spassigl/KicadLibs/3D Models/D6R90F1LFS.stp

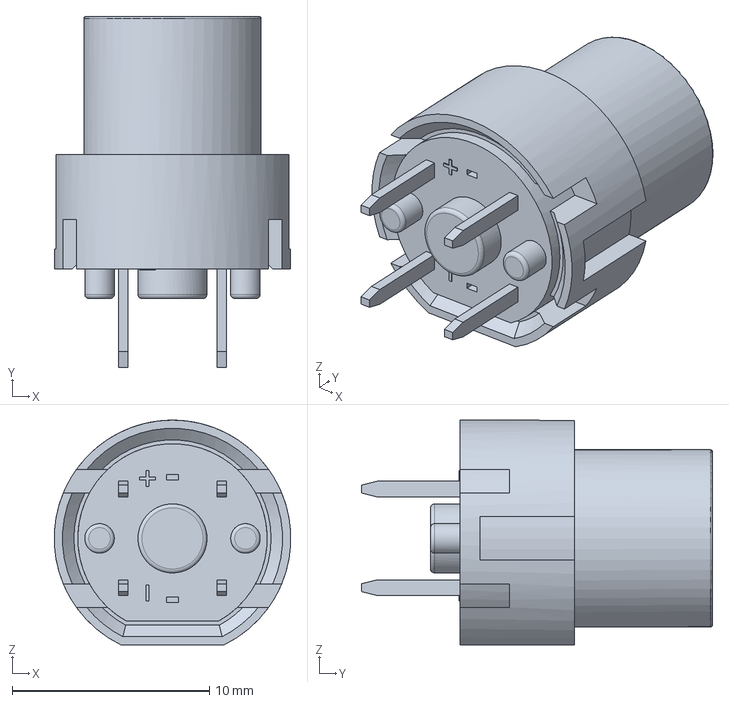
[picture p1: CAD file, 2026-04-27]
3D Models/D6R90F1LFS.stp
12.0 x 17.8 x 11.4 mm
