spassigl/KicadLibs/3D Models/GT-TC149B-H150-L1.step

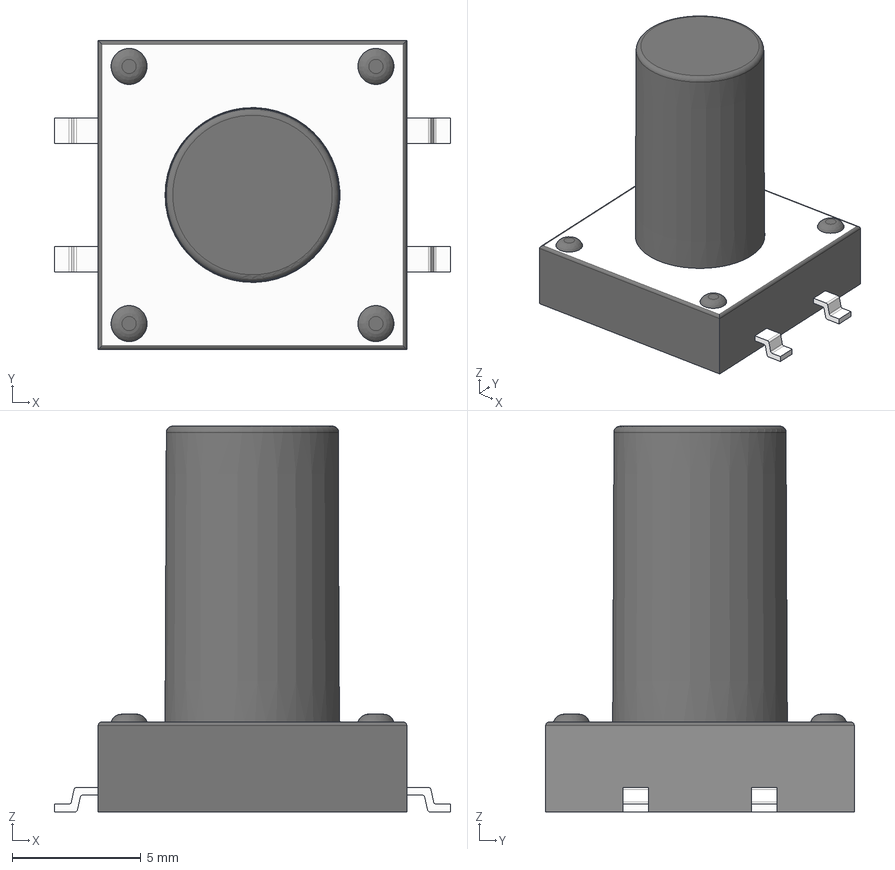
[picture p2: CAD file, 2026-04-27]
3D Models/GT-TC149B-H150-L1.step
15.4 x 12.0 x 15.0 mm
Base
Plunger
J-Lead
