spassigl/KicadLibs/3D Models/Cap.step

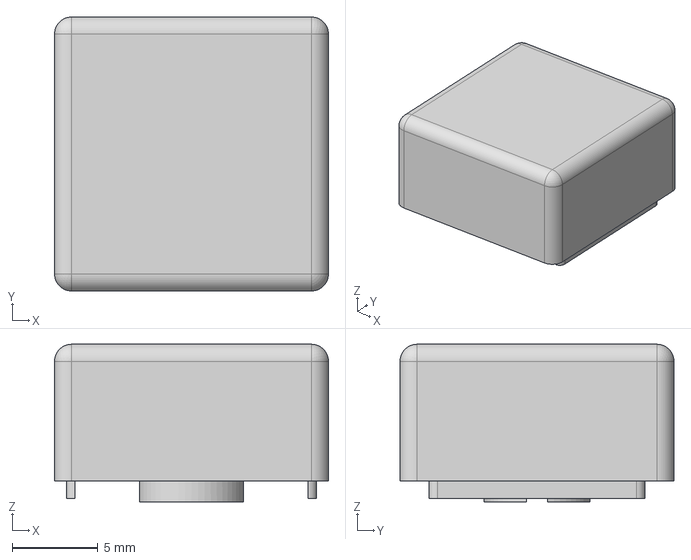
[picture p3: CAD file, 2026-04-27]
3D Models/Cap.step
16.0 x 16.0 x 9.20 mm
