spassigl/KicadLibs/3D Models/KS DELPS1.22.step

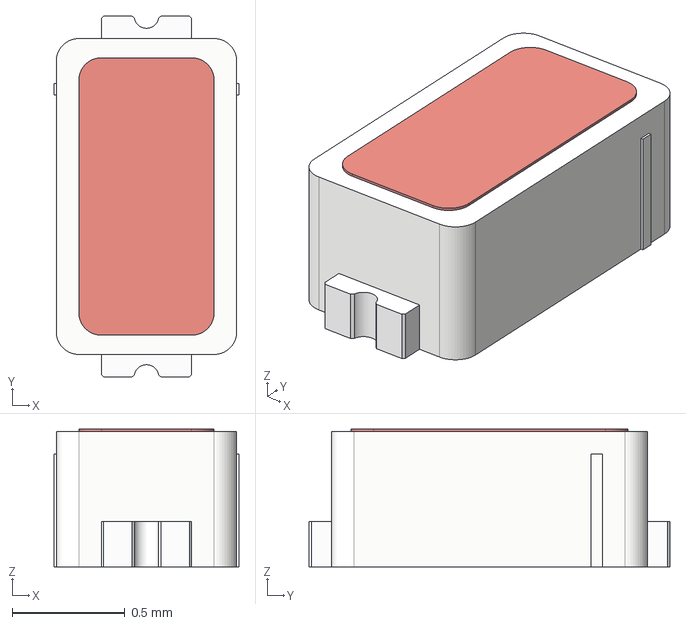
[picture p4: CAD file, 2026-04-27]
3D Models/KS DELPS1.22.step
0.82 x 1.60 x 0.61 mm
