spassigl/KicadLibs/3D Models/6Jxxx.stp

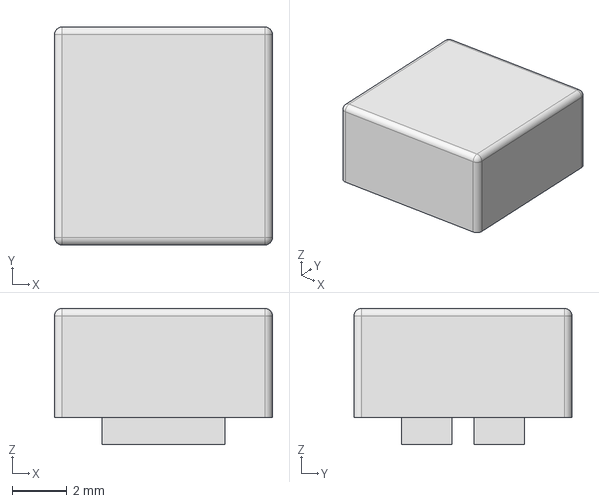
[picture p5: CAD file, 2026-04-27]
3D Models/6Jxxx.stp
8.00 x 8.00 x 5.00 mm
