spassigl/KicadLibs/3D Models/320.02E11xxx + 320.094.step

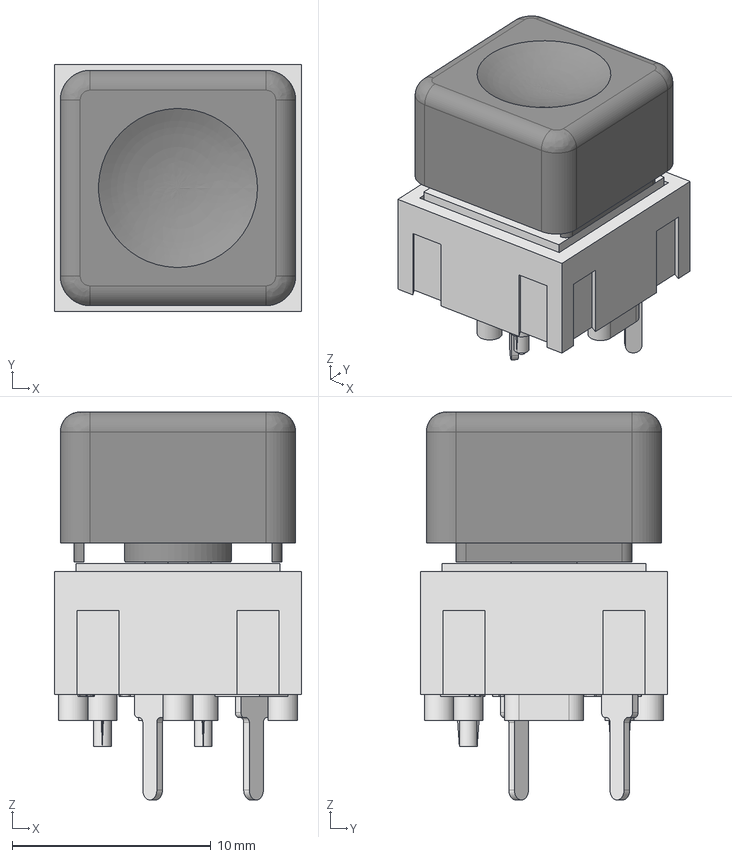
[picture p6: CAD file, 2026-04-27]
3D Models/320.02E11xxx + 320.094.step
12.5 x 12.4 x 19.5 mm
