spassigl/KicadLibs/3D Models/Heling_MJ56882-B111-HR1-C.step

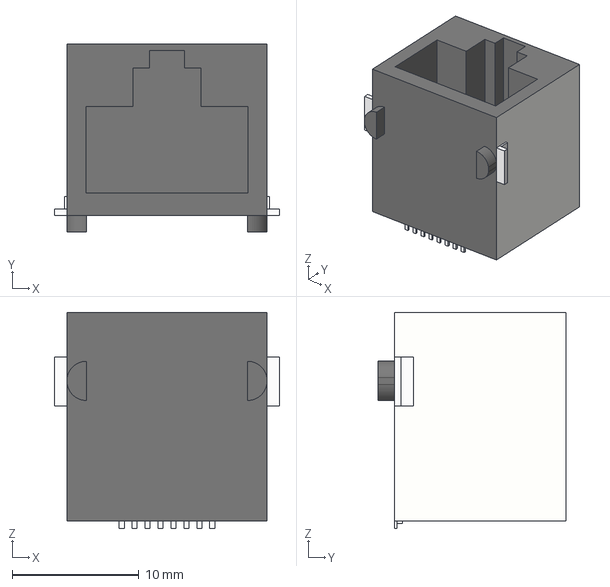
[picture p7: CAD file, 2026-04-27]
3D Models/Heling_MJ56882-B111-HR1-C.step
17.8 x 14.8 x 17.1 mm
