spassigl/KicadLibs/3D Models/320.02E11xxx.stp

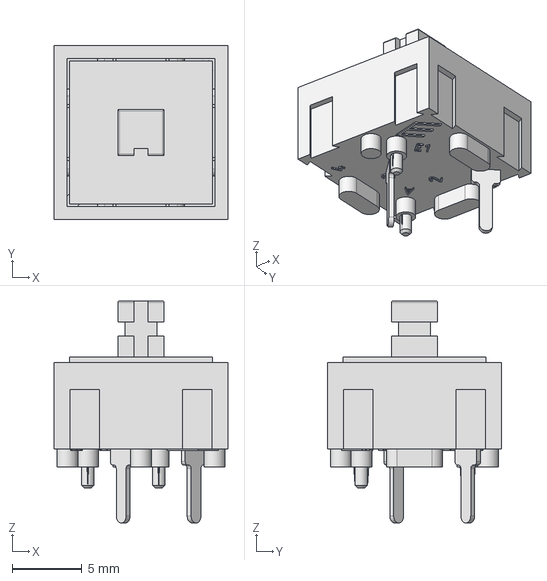
[picture p8: CAD file, 2026-04-27]
3D Models/320.02E11xxx.stp
12.5 x 12.4 x 15.9 mm
