spassigl/KicadLibs/3D Models/HRO TYPE-C-31-M-12.step

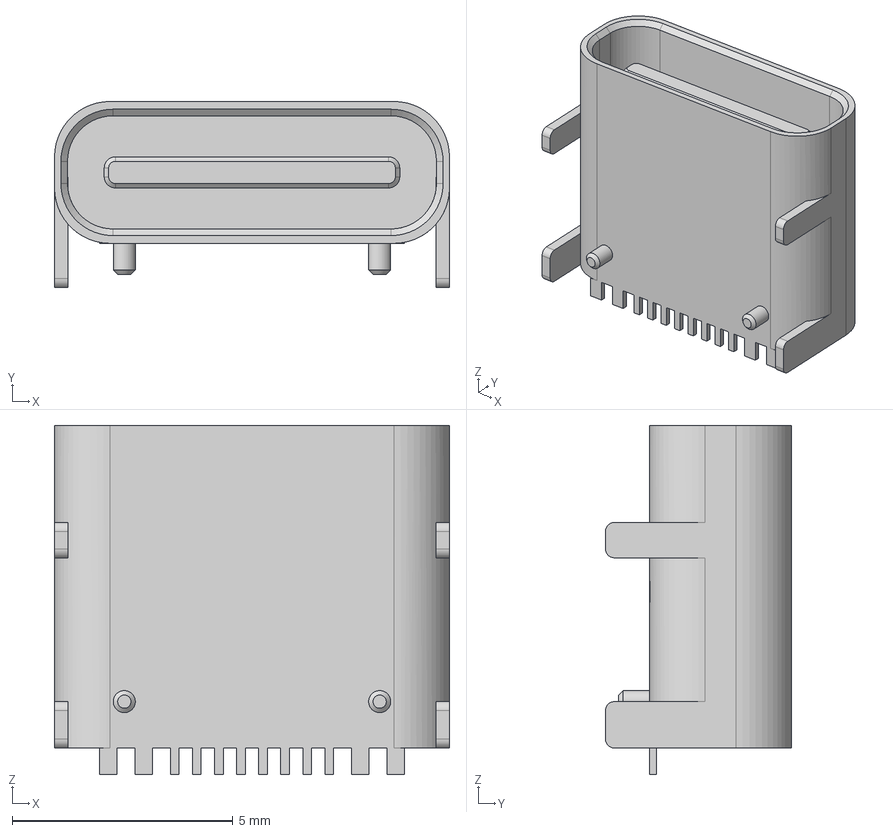
[picture p9: CAD file, 2026-04-27]
3D Models/HRO TYPE-C-31-M-12.step
8.94 x 4.21 x 7.90 mm
