spassigl/KicadLibs/3D Models/TL1100FFxxxx.stp

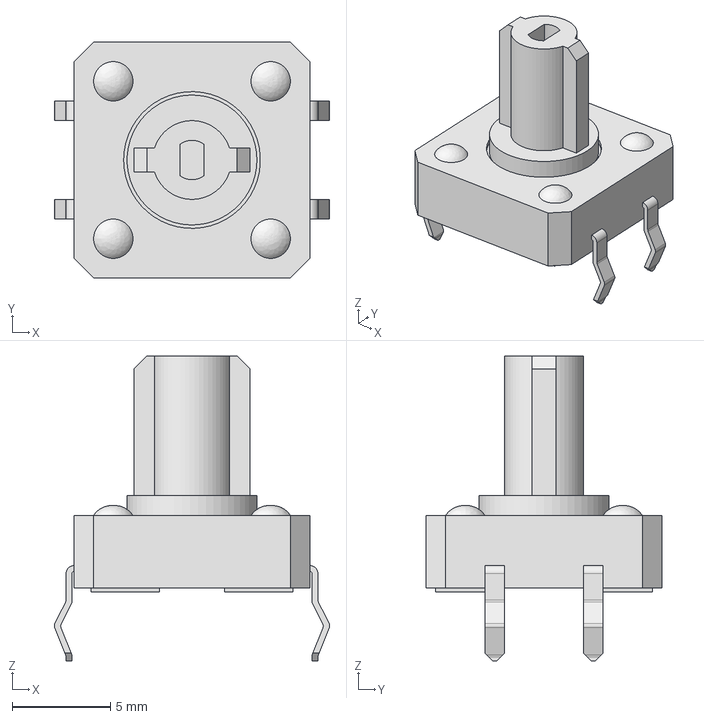
[picture p10: CAD file, 2026-04-27]
3D Models/TL1100FFxxxx.stp
14.0 x 12.0 x 15.5 mm
