spassigl/KicadLibs/3D Models/Omron G5Q-14.step

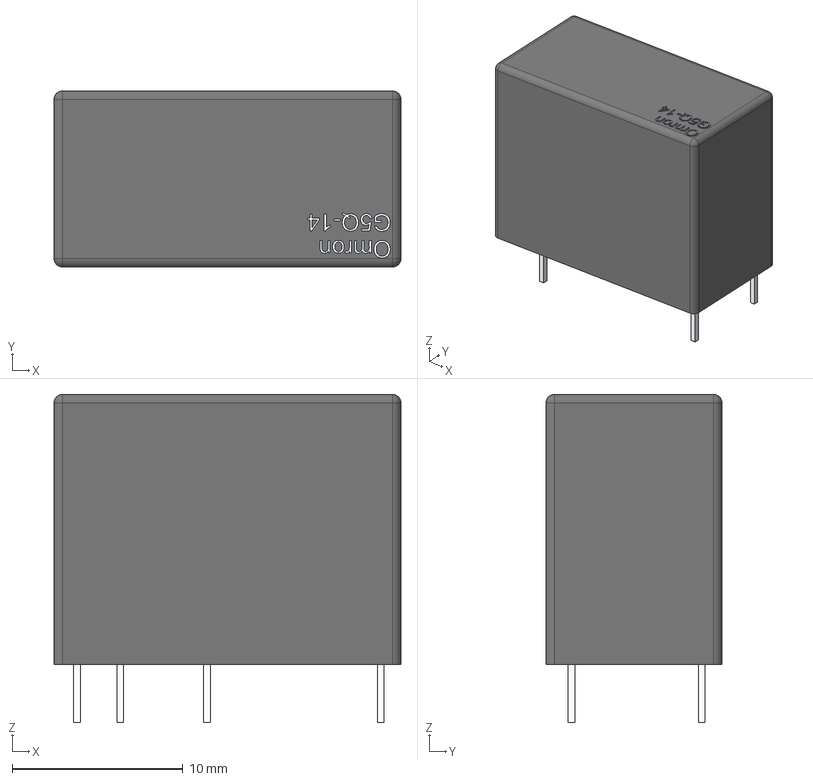
[picture p11: CAD file, 2026-04-27]
3D Models/Omron G5Q-14.step
20.3 x 10.3 x 19.2 mm
