spassigl/KicadLibs/3D Models/TS-1045-A13B3-D2.step

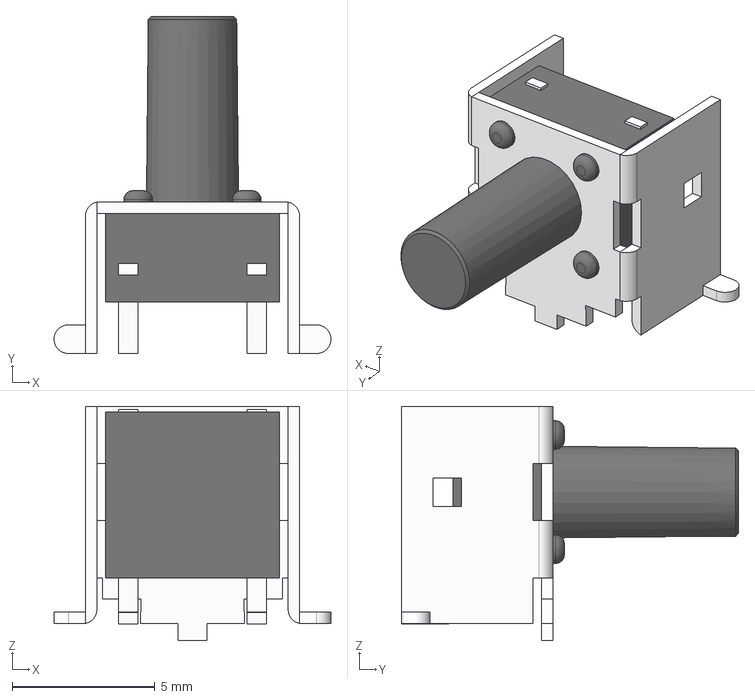
[picture p12: CAD file, 2026-04-27]
3D Models/TS-1045-A13B3-D2.step
9.70 x 11.8 x 8.20 mm
Cage
Switch body
