spassigl/KicadLibs/3D Models/PC817SMD-4.step

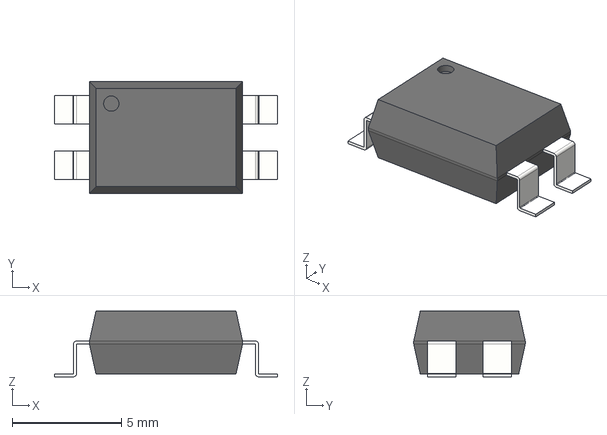
[picture p13: CAD file, 2026-04-27]
3D Models/PC817SMD-4.step
10.2 x 5.10 x 3.00 mm
