spassigl/KicadLibs/3D Models/B3F-105x.step

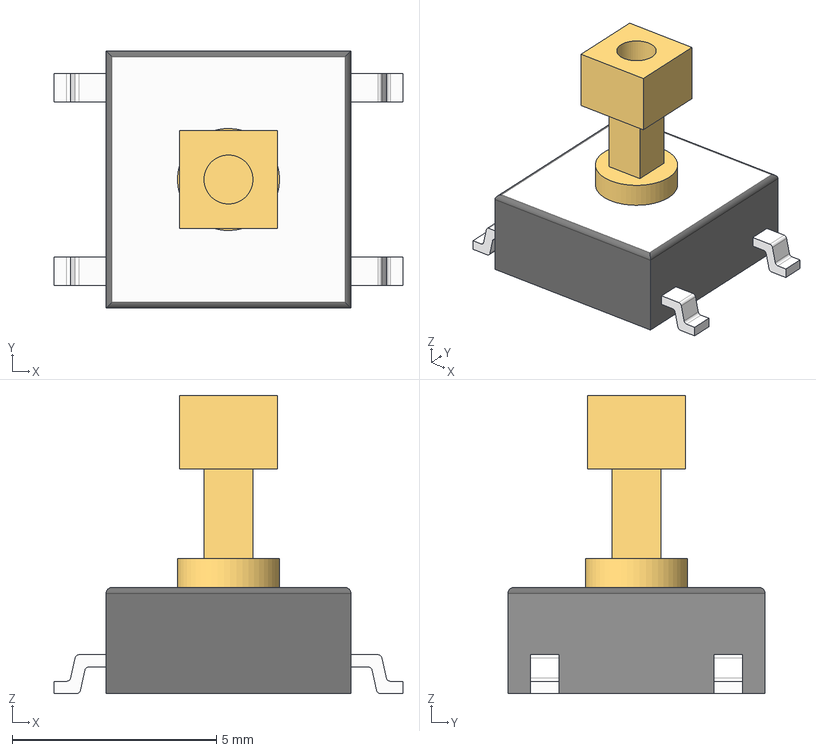
[picture p14: CAD file, 2026-04-27]
3D Models/B3F-105x.step
8.55 x 6.30 x 7.30 mm
Base
J-Lead
Plunger
