spassigl/KicadLibs/3D Models/MLT-9650.step

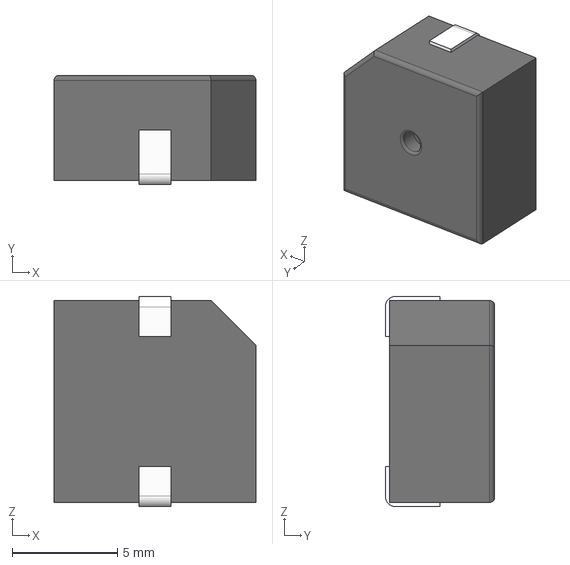
[picture p15: CAD file, 2026-04-27]
3D Models/MLT-9650.step
9.60 x 5.20 x 10.0 mm
