spassigl/KicadLibs/3D Models/PEC12R-4x22F-nxxxx.stp

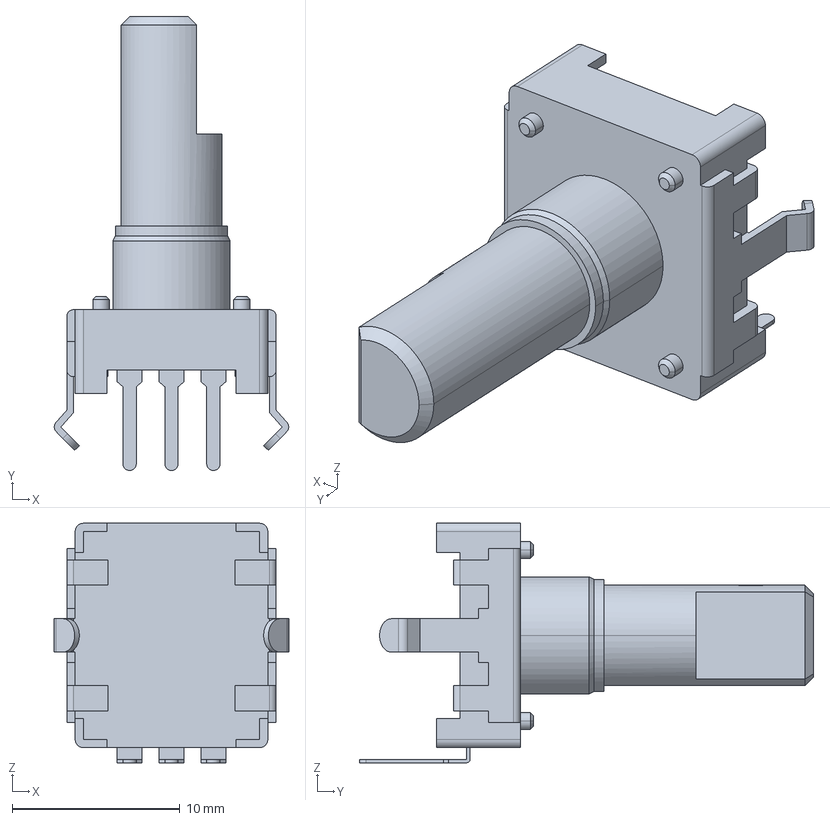
[picture p16: CAD file, 2026-04-27]
3D Models/PEC12R-4x22F-nxxxx.stp
14.0 x 27.1 x 14.3 mm
