spassigl/KicadLibs/3D Models/WQFN20_RUK_TEX.step

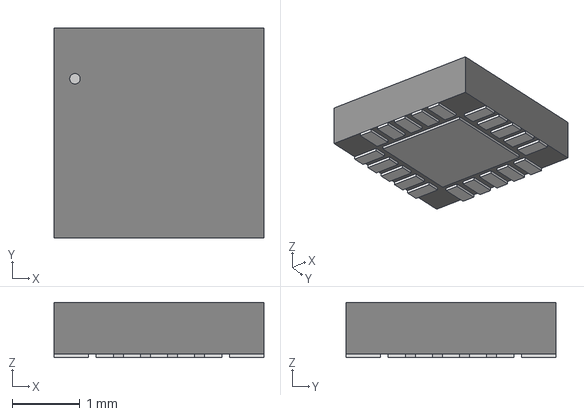
[picture p17: CAD file, 2026-04-27]
3D Models/WQFN20_RUK_TEX.step
3.10 x 3.10 x 0.815 mm
