spassigl/KicadLibs/3D Models/PTS126Jx73-SMT.step

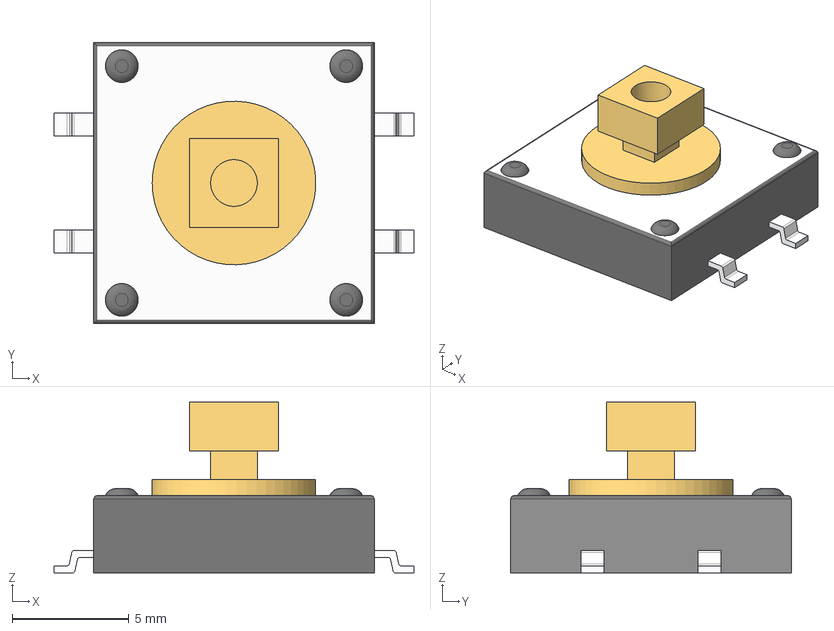
[picture p18: CAD file, 2026-04-27]
3D Models/PTS126Jx73-SMT.step
15.4 x 12.0 x 7.31 mm
Base
J-Lead
Plunger
