spassigl/KicadLibs/3D Models/KRTB LFLP71.32.step

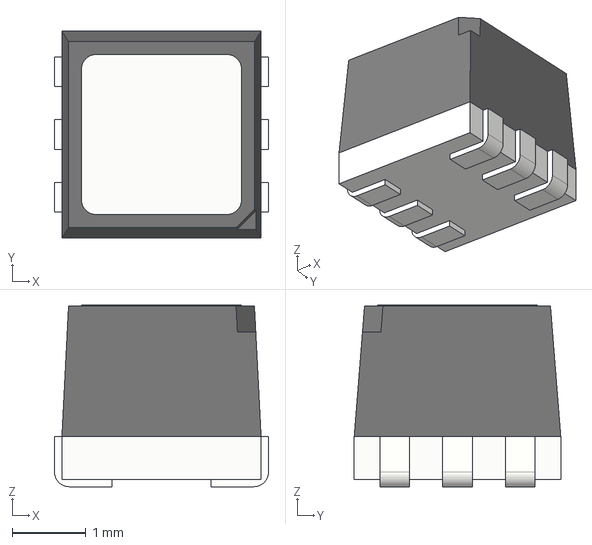
[picture p19: CAD file, 2026-04-27]
3D Models/KRTB LFLP71.32.step
2.90 x 2.80 x 2.46 mm
