spassigl/KicadLibs/3D Models/Encoder Knob D Shaft.step

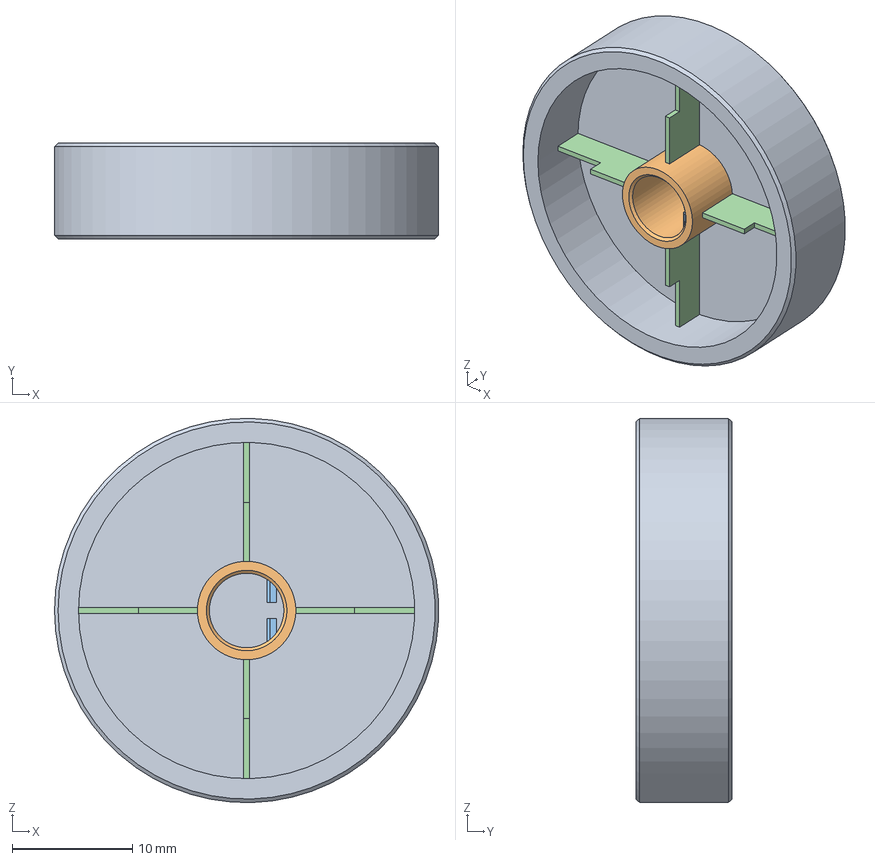
[picture p20: CAD file, 2026-04-27]
3D Models/Encoder Knob D Shaft.step
32.0 x 8.00 x 32.0 mm
