spassigl/KicadLibs/3D Models/ConnFly_DS1128_NoLED.step

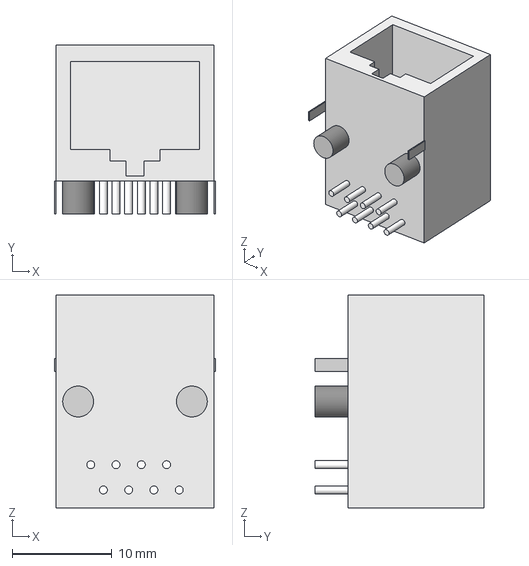
[picture p21: CAD file, 2026-04-27]
3D Models/ConnFly_DS1128_NoLED.step
16.2 x 16.9 x 21.4 mm
