spassigl/KicadLibs/3D Models/320.094xxx.stp

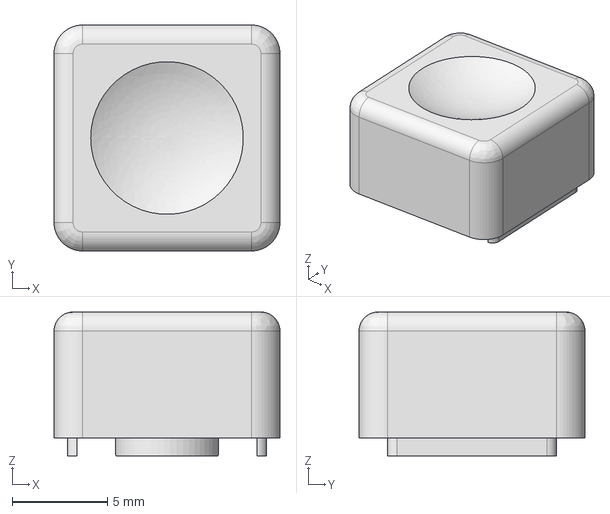
[picture p22: CAD file, 2026-04-27]
3D Models/320.094xxx.stp
11.8 x 11.8 x 7.55 mm
