spassigl/KicadLibs/3D Models/HF32FA.stp

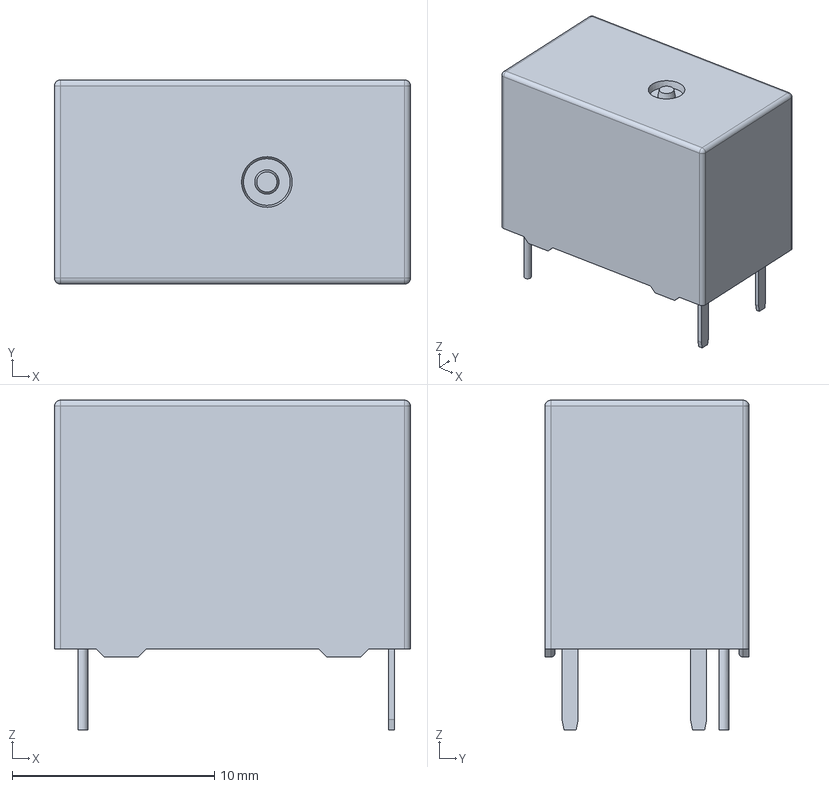
[picture p23: CAD file, 2026-02-20]
3D Models/HF32FA.stp
17.6 x 10.1 x 16.3 mm
