spassigl/KicadLibs/3D Models/WJ128V-5.0-02P-14-00A.step

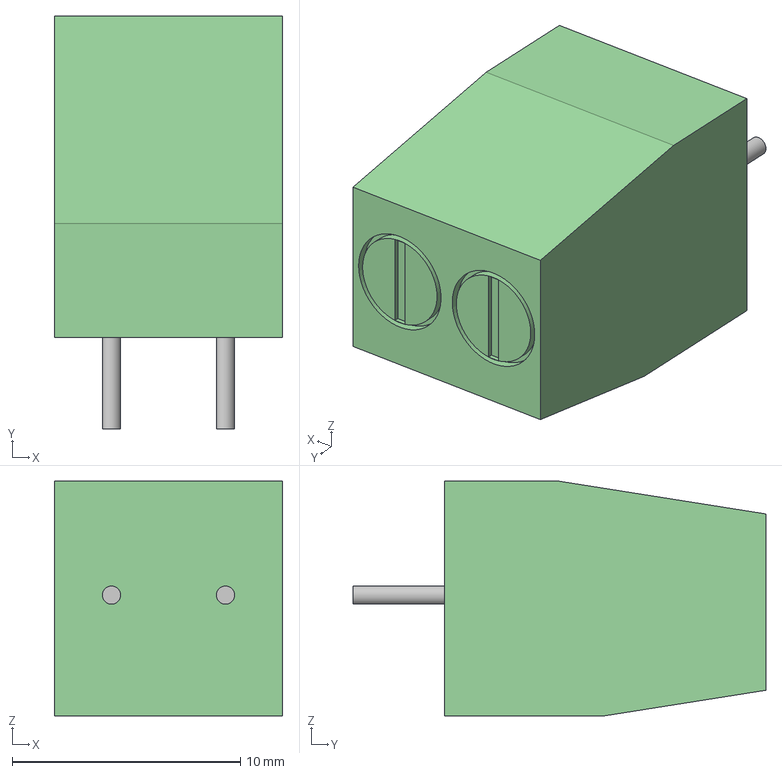
[picture p24: CAD file, 2026-02-20]
3D Models/WJ128V-5.0-02P-14-00A.step
10.0 x 18.1 x 10.3 mm
