spassigl/KicadLibs/3D Models/WJ129V-7.62-02P.step

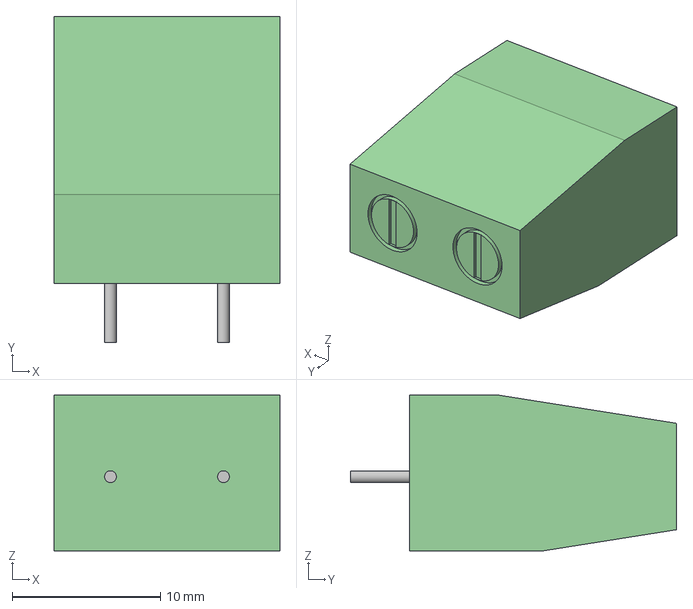
[picture p25: CAD file, 2026-02-20]
3D Models/WJ129V-7.62-02P.step
15.2 x 22.0 x 10.5 mm
