spassigl/KicadLibs/3D Models/FJ81XXXH.step

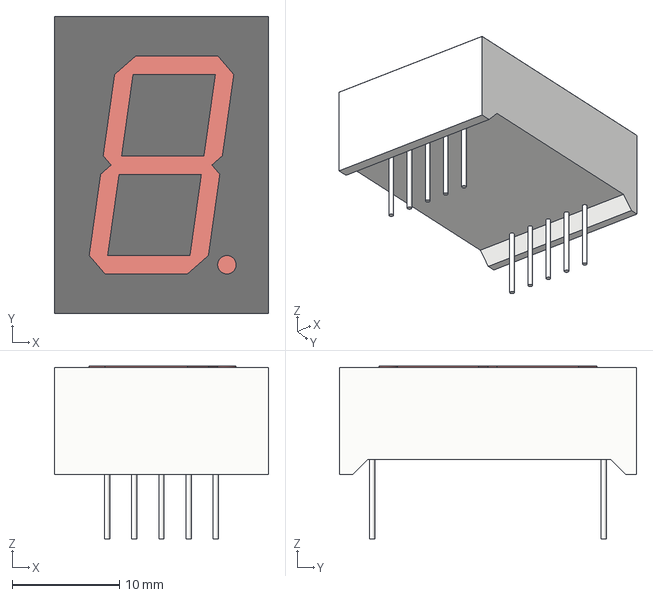
[picture p26: CAD file, 2026-02-15]
3D Models/FJ81XXXH.step
20.0 x 27.7 x 16.1 mm
