spassigl/KicadLibs/3D Models/SFN-12055PA6.5.step

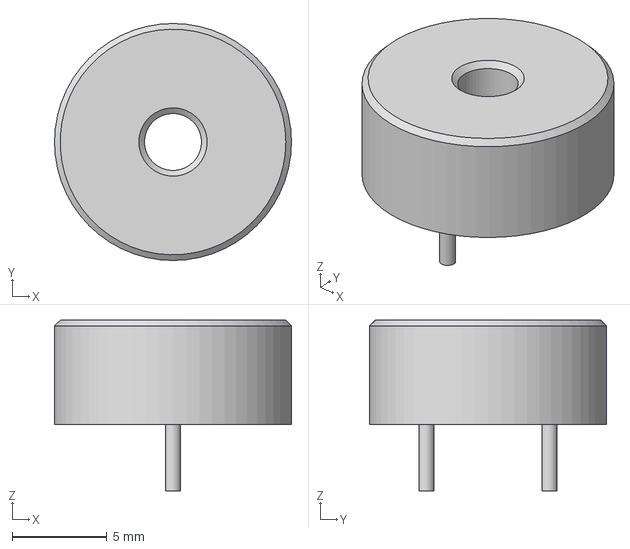
[picture p27: CAD file, 2026-02-15]
3D Models/SFN-12055PA6.5.step
12.5 x 12.5 x 9.00 mm
