spassigl/KicadLibs/3D Models/ESD5B5.step

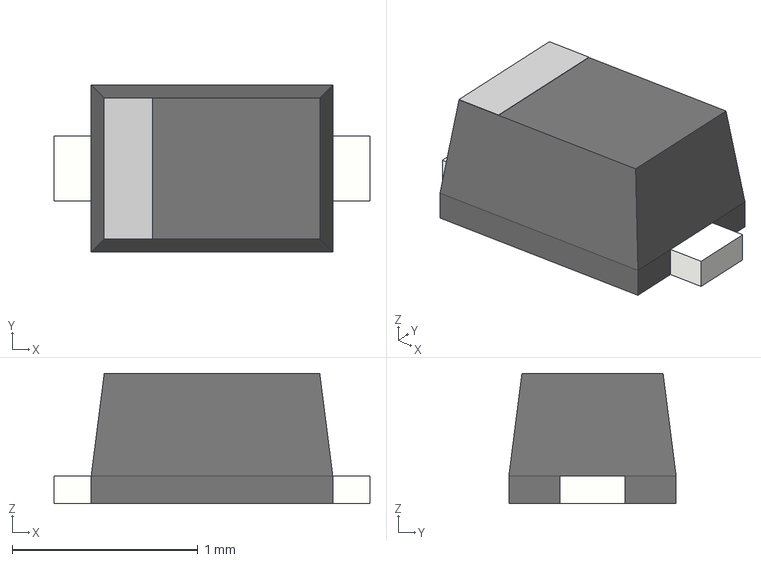
[picture p28: CAD file, 2026-02-15]
3D Models/ESD5B5.step
1.70 x 0.9 x 0.702 mm
