spassigl/KicadLibs/3D Models/NUP4114.step

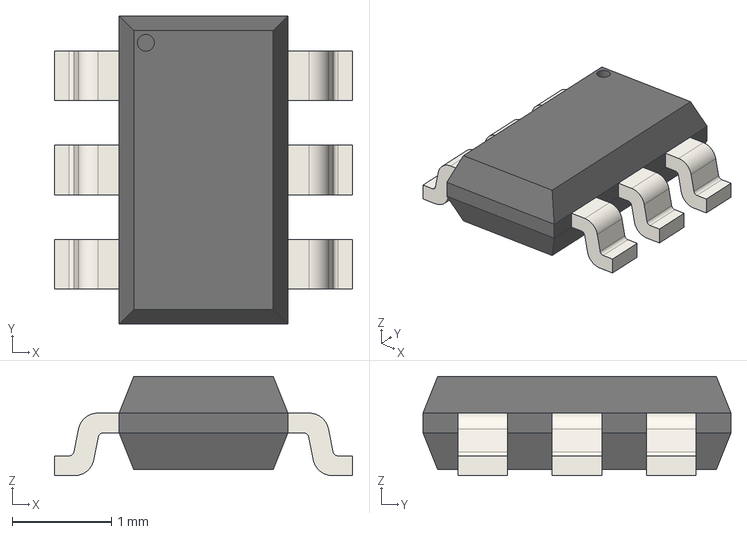
[picture p29: CAD file, 2026-02-15]
3D Models/NUP4114.step
3.00 x 3.10 x 1.00 mm
