spassigl/KicadLibs/3D Models/TM1637-DIP20.step

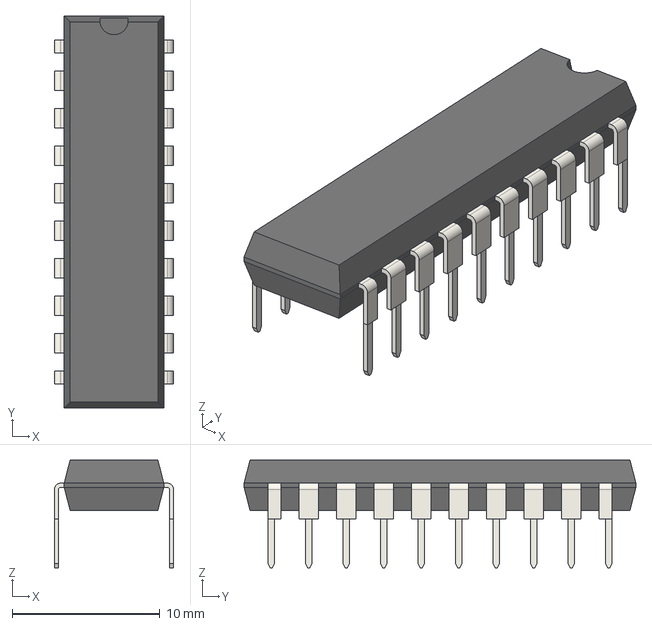
[picture p30: CAD file, 2026-02-15]
3D Models/TM1637-DIP20.step
8.06 x 26.5 x 7.30 mm
