spassigl/KicadLibs/3D Models/Schurter 0751.0110-2.step

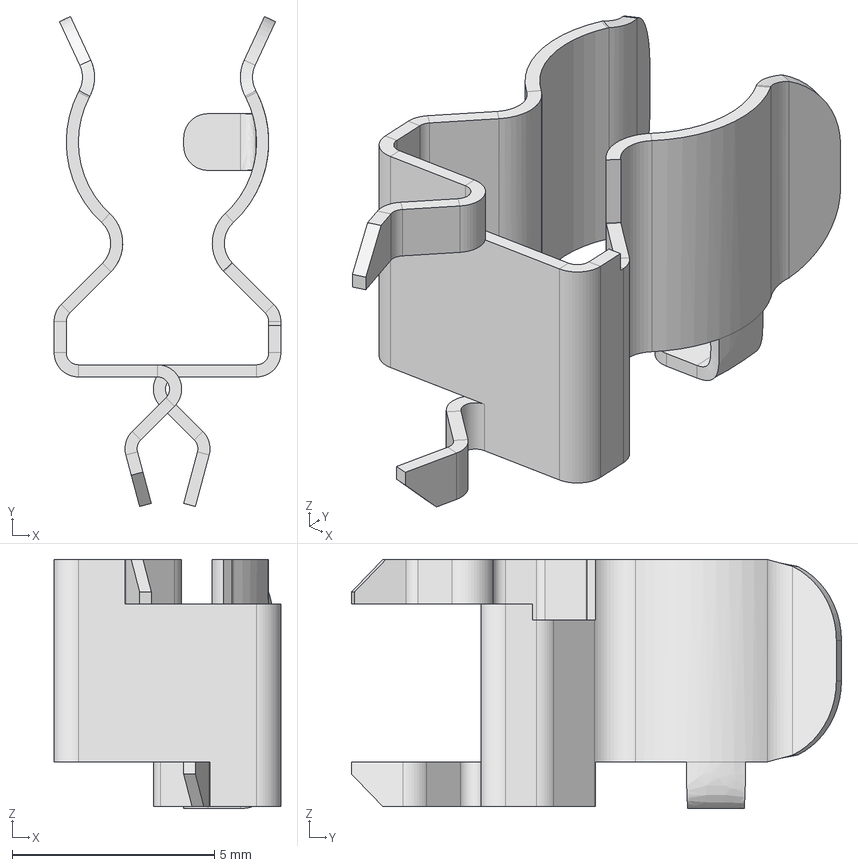
[picture p31: CAD file, 2026-02-15]
3D Models/Schurter 0751.0110-2.step
5.60 x 12.1 x 6.15 mm
