spassigl/KicadLibs/3D Models/IRM-10-5.step

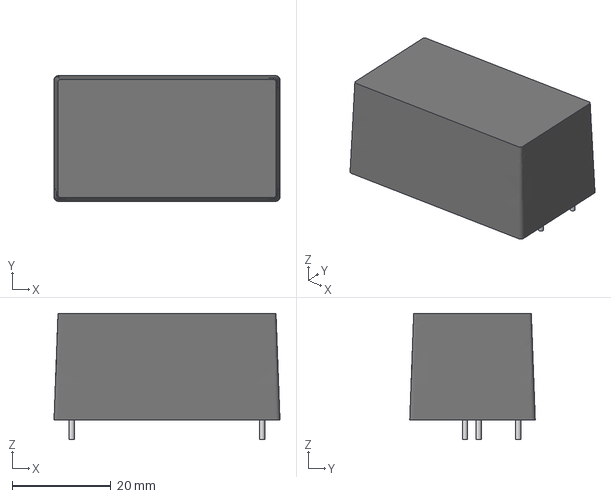
[picture p32: CAD file, 2026-02-15]
3D Models/IRM-10-5.step
45.7 x 25.4 x 25.5 mm
