spassigl/KicadLibs/3D Models/D6CXXF1LFS.step

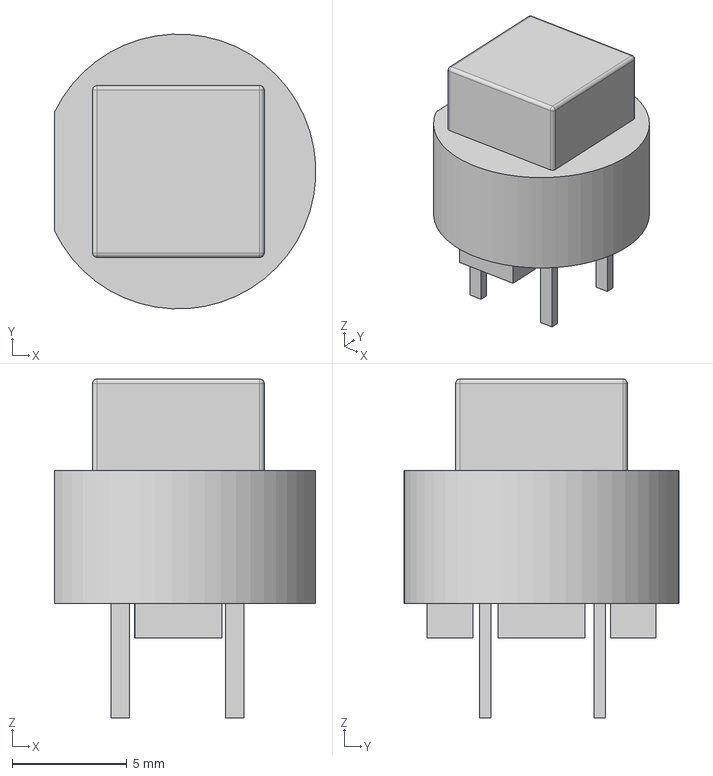
[picture p33: CAD file, 2026-02-15]
3D Models/D6CXXF1LFS.step
11.4 x 12.0 x 14.8 mm
