spassigl/KicadLibs/3D Models/07D511.step

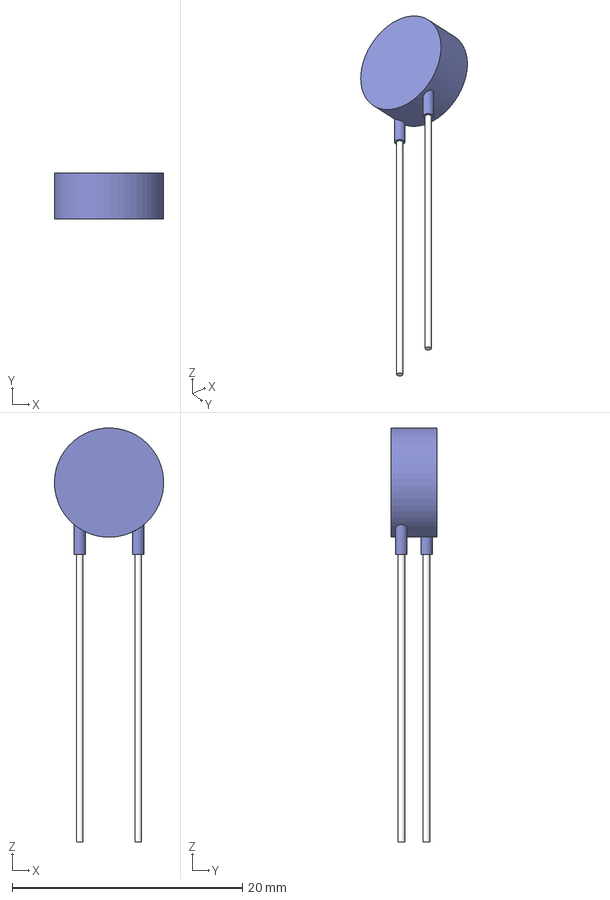
[picture p34: CAD file, 2026-02-15]
3D Models/07D511.step
9.49 x 4.00 x 36.0 mm
