spassigl/KicadLibs/3D Models/SPEF220100.step

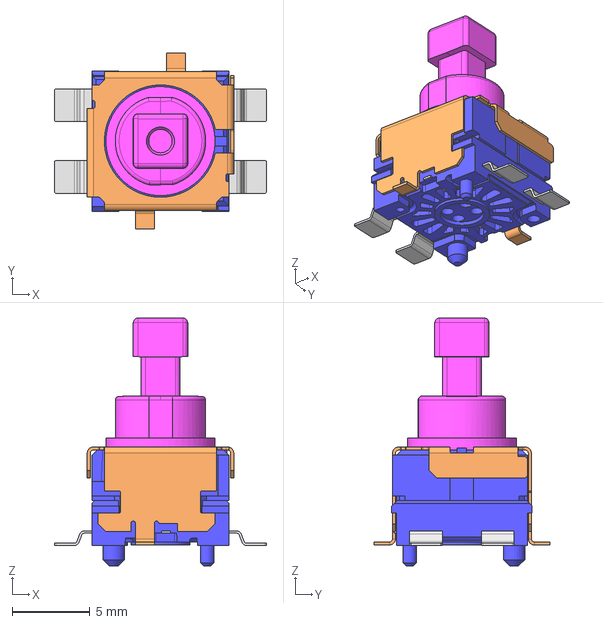
[picture p35: CAD file, 2026-02-15]
3D Models/SPEF220100.step
13.6 x 11.3 x 15.9 mm
