spassigl/KicadLibs/3D Models/TPD2E1B06.step

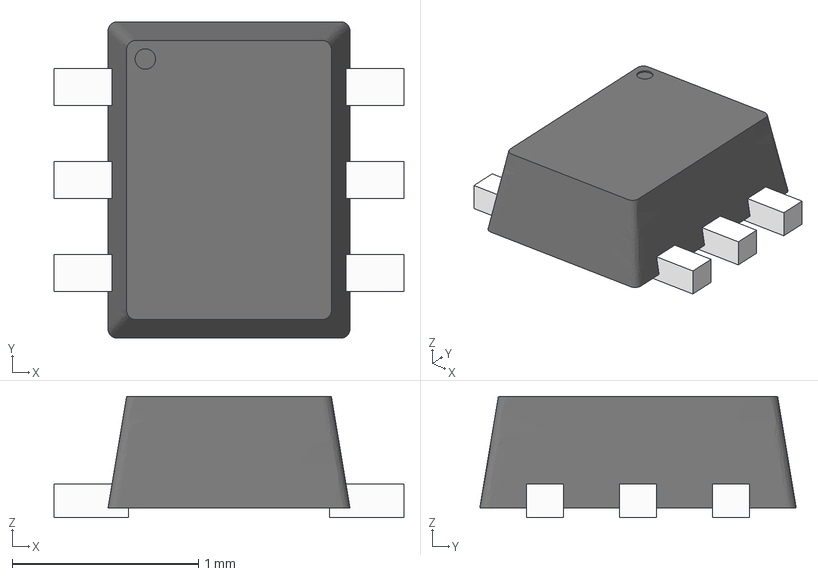
[picture p36: CAD file, 2026-02-15]
3D Models/TPD2E1B06.step
1.88 x 1.70 x 0.65 mm
