spassigl/KicadLibs/3D Models/G5CA-1A4.step

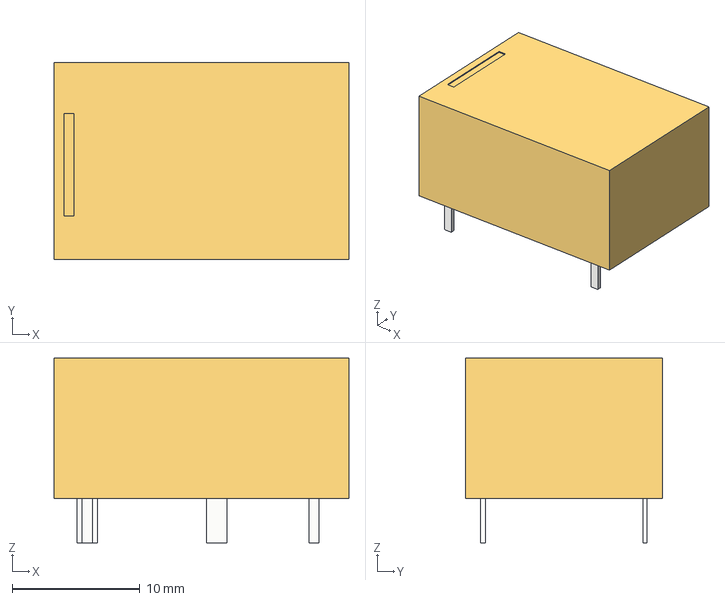
[picture p37: CAD file, 2026-02-15]
3D Models/G5CA-1A4.step
23.1 x 15.5 x 14.5 mm
