spassigl/KicadLibs/3D Models/NUD3124.step

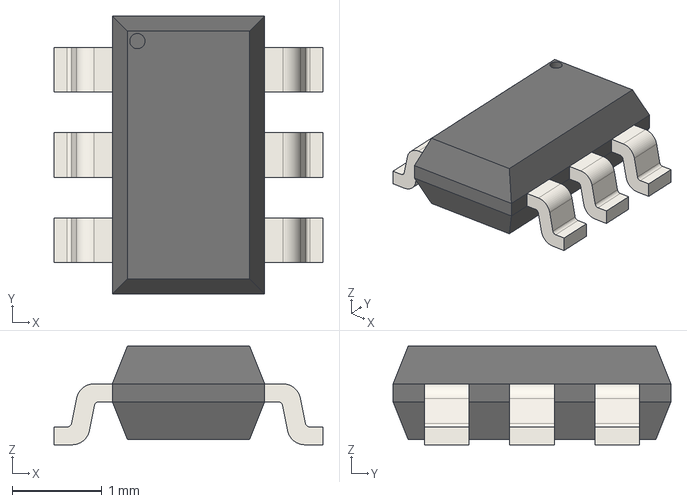
[picture p38: CAD file, 2026-02-15]
3D Models/NUD3124.step
3.00 x 3.10 x 1.10 mm
