spassigl/KicadLibs/3D Models/MAX7219-SOIC.step

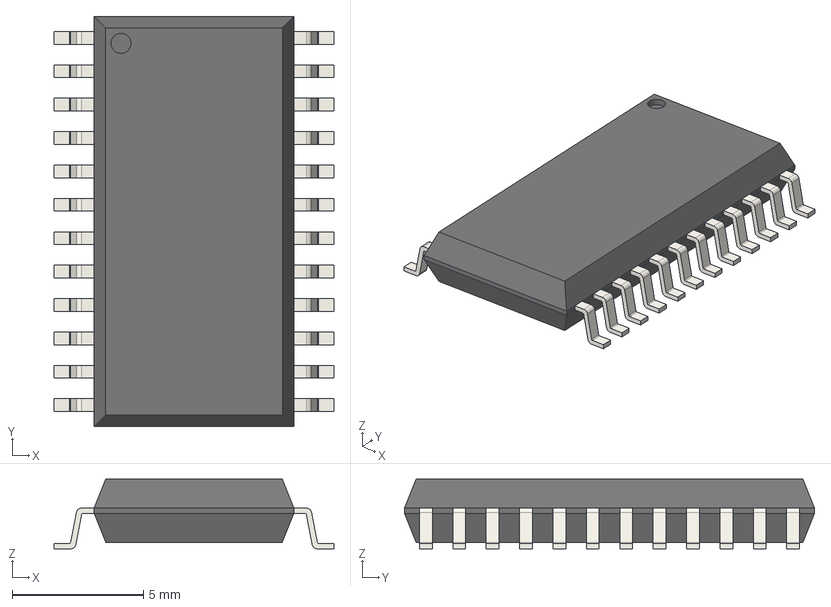
[picture p39: CAD file, 2026-02-15]
3D Models/MAX7219-SOIC.step
10.7 x 15.6 x 2.65 mm
