spassigl/KicadLibs/3D Models/TS-1095PD-A17B3-D2.step

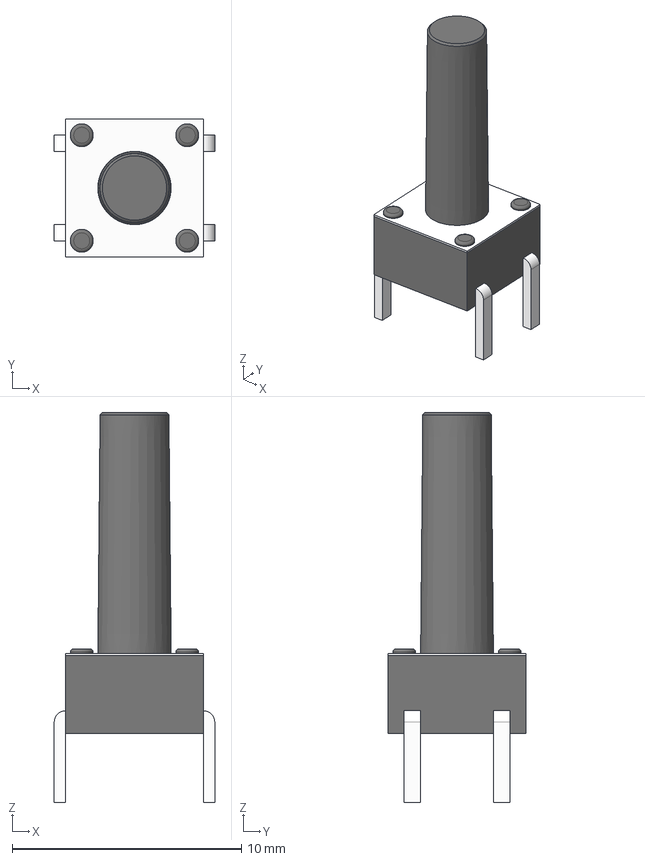
[picture p40: CAD file, 2026-02-15]
3D Models/TS-1095PD-A17B3-D2.step
7.00 x 6.00 x 17.0 mm
