spassigl/KicadLibs/3D Models/KW1-802.step

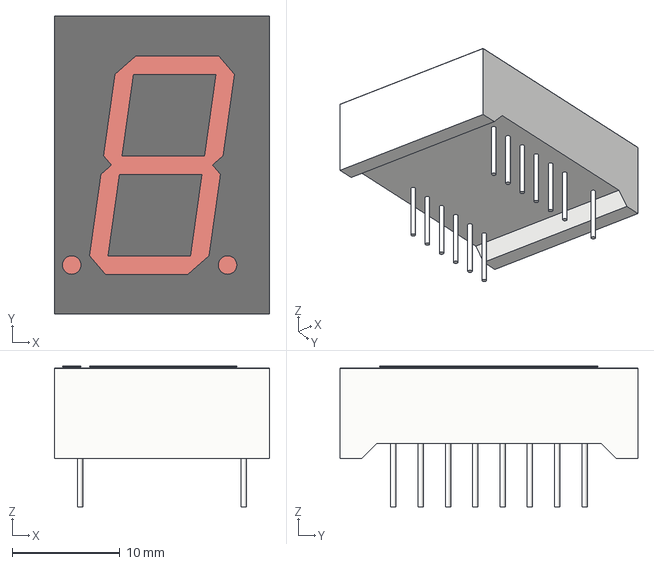
[picture p41: CAD file, 2026-02-15]
3D Models/KW1-802.step
20.0 x 27.7 x 13.1 mm
