spassigl/KicadLibs/3D Models/SSSF012100.step

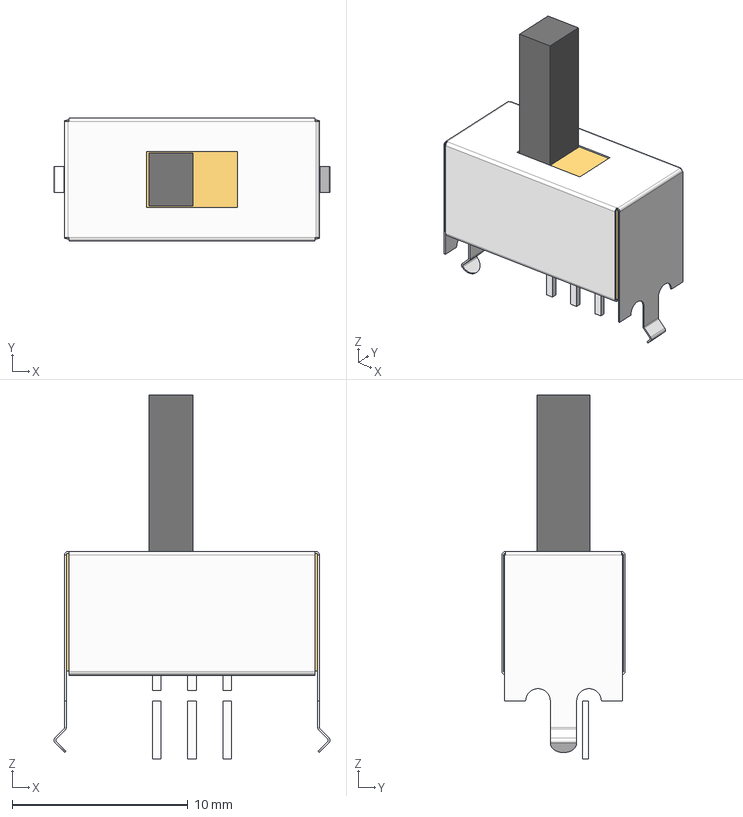
[picture p42: CAD file, 2026-02-15]
3D Models/SSSF012100.step
15.7 x 7.00 x 20.7 mm
Cover
Actuator
