spassigl/KicadLibs/3D Models/KW3-801AVB-CVB.step

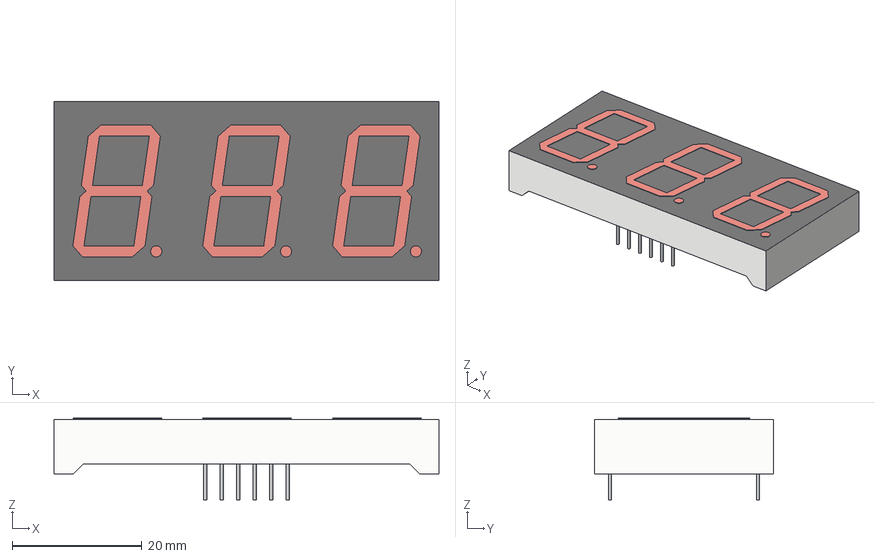
[picture p43: CAD file, 2026-02-15]
3D Models/KW3-801AVB-CVB.step
59.3 x 27.5 x 12.6 mm
