spassigl/KicadLibs/3D Models/MAX7219-DIP24.step

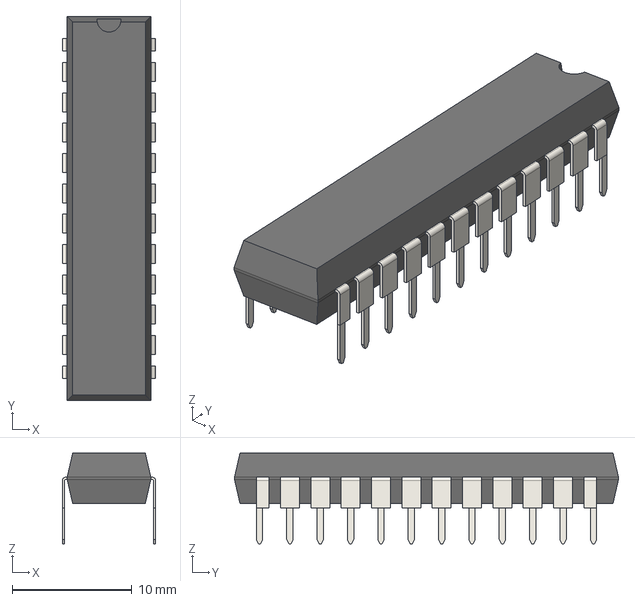
[picture p44: CAD file, 2026-02-15]
3D Models/MAX7219-DIP24.step
7.82 x 32.1 x 7.60 mm
