spassigl/KicadLibs/3D Models/TM1637-SOP20.step

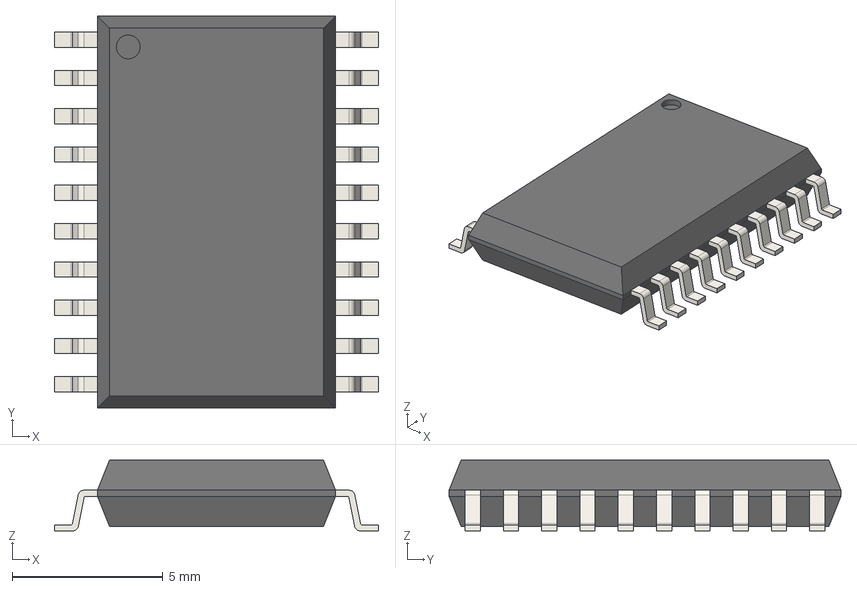
[picture p45: CAD file, 2026-02-15]
3D Models/TM1637-SOP20.step
10.8 x 13.0 x 2.35 mm
