spassigl/KicadLibs/(list of files, cad)

Other CAD files:
3D Models/KW DELSS2.CC.step
3D Models/FJ8301BH.step
3D Models/0530470210.stp
3D Models/0530470410.stp
3D Models/SM420501N_8.step
3D Models/SM420806N8.step
