spassigl/KicadLibs/Design Blocks/Interfaces.kicad_blocks/I2C extender + RJ45 + ESD protection .kicad_block/I2C extender + RJ45 + ESD protection .kicad_sch

## KiCad design Design Blocks/Interfaces.kicad_blocks/I2C extender + RJ45 + ESD protection .kicad_block/I2C extender + RJ45 + ESD protection .kicad_sch (2026-04-27)

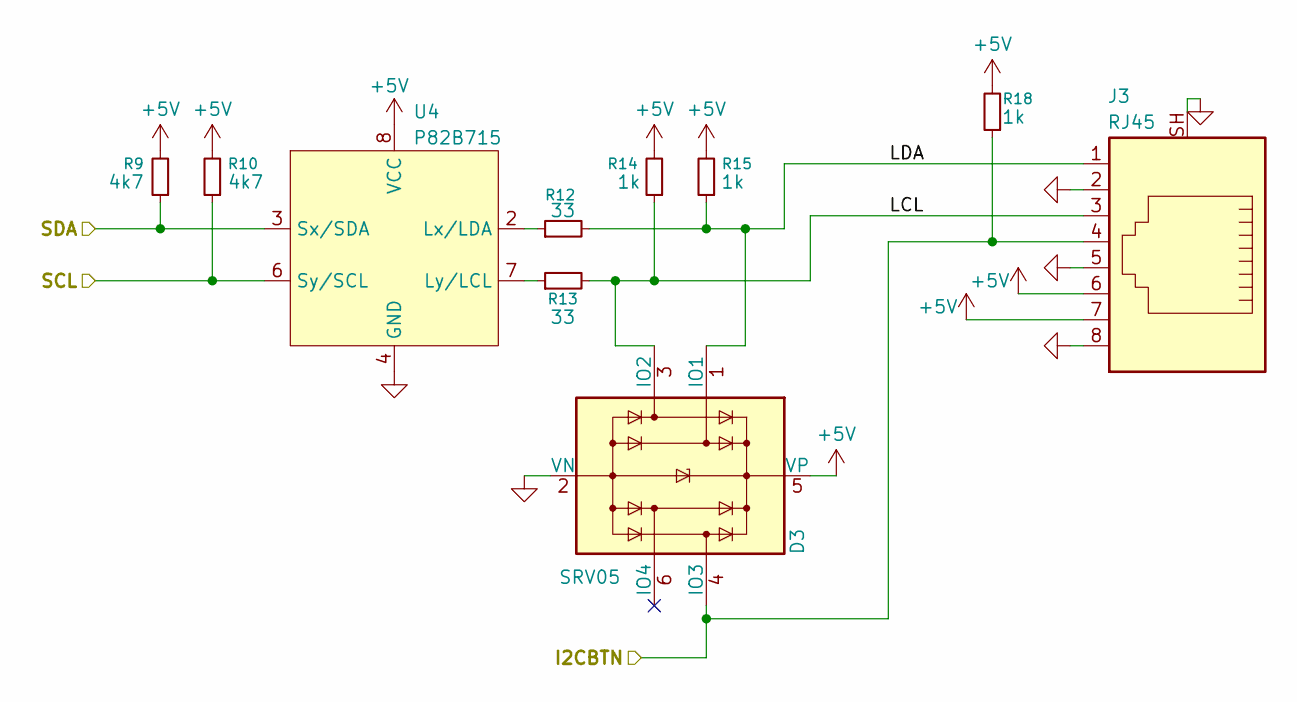
[picture p46: schematic I2C extender + RJ45 + ESD protection .kicad_sch]

Parts:
D3: SRV05; SOT-23-6; LCSC C85364
J3: RJ45; Connector_RJ45_Heling_MJ56882-B111-HR1-C
R9, R10: 4k7; R_0603_1608Metric; LCSC C23162
R12, R13: 33; R_0603_1608Metric
R14, R15, R18: 1k; R_0603_1608Metric; LCSC C25804
U4: P82B715; SOIC-8_3.9x4.9mm_P1.27mm

Connections:
+5V: D3.5 (VP), J3.6, J3.7, R9.2, R10.2, R14.2, R15.2, R18.2, U4.8 (VCC)
GND: D3.2 (VN), J3.2, J3.5, J3.8, J3.SH, U4.4 (GND)
I2CBTN: D3.4 (IO3), J3.4, R18.1
LCL: D3.3 (IO2), J3.3, R13.2, R14.1
LDA: D3.1 (IO1), J3.1, R12.2, R15.1
unnamed: R12.1, U4.2 (Lx/LDA)
unnamed: R13.1, U4.7 (Ly/LCL)
unnamed: U4.1 (NC), U4.5 (NC)
SCL: R10.1, U4.6 (Sy/SCL)
SDA: R9.1, U4.3 (Sx/SDA)
