spassigl/KicadLibs/Design Blocks/Interfaces.kicad_blocks/USBC + CH340X + ESD protection.kicad_block/USBC + CH340X + ESD protection.kicad_sch

## KiCad design Design Blocks/Interfaces.kicad_blocks/USBC + CH340X + ESD protection.kicad_block/USBC + CH340X + ESD protection.kicad_sch (2026-04-27)

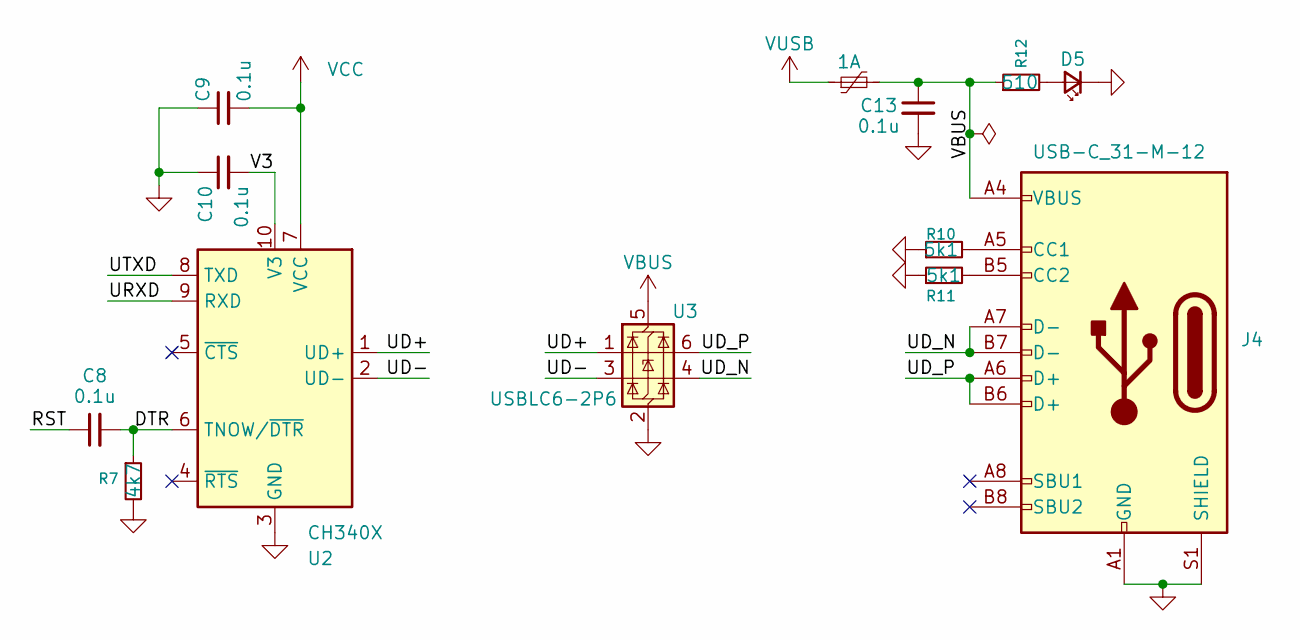
[picture p47: schematic USBC + CH340X + ESD protection.kicad_sch]

Parts:
C8, C9, C10, C13: 0.1u; C_0603_1608Metric; LCSC C14663
D5: LED; LED_0603_1608Metric; LCSC C2286
F1: 1A; Fuse_1206_3216Metric; LCSC C69688
J4: USB-C_31-M-12; USB_C_Receptacle_HRO_TYPE-C-31-M-12; LCSC C165948
R7: 4k7; R_0603_1608Metric; LCSC C23162
R10, R11: 5k1; R_0603_1608Metric; LCSC C23186
R12: 510; R_0603_1608Metric; LCSC C23193
U2: CH340X; MSOP-10_3x3mm_P0.5mm; LCSC C84681
U3: USBLC6-2P6; SOT-666; LCSC C15999

Connections:
DTR: C8.2, R7.1, U2.6 (TNOW/~DTR)
GND: C9.1, C10.1, C13.2, D5.1 (K), J4.A1 (GND), J4.A12 (GND), J4.B1 (GND), J4.B12 (GND), J4.S1 (SHIELD), R7.2, R10.1, R11.1, U2.3 (GND), U3.2 (GND)
unnamed: D5.2 (A), R12.2
unnamed: J4.A5 (CC1), R10.2
unnamed: J4.B5 (CC2), R11.2
RST: C8.1
UD+: U2.1 (UD+), U3.1 (I/O1)
UD-: U2.2 (UD-), U3.3 (I/O2)
UD_N: J4.A7 (D-), J4.B7 (D-), U3.4 (I/O2)
UD_P: J4.A6 (D+), J4.B6 (D+), U3.6 (I/O1)
URXD: U2.9 (RXD)
UTXD: U2.8 (TXD)
V3: C10.2, U2.10 (V3)
VBUS: C13.1, F1.2, J4.A4 (VBUS), J4.A9 (VBUS), J4.B4 (VBUS), J4.B9 (VBUS), R12.1, U3.5 (VBUS)
VCC: C9.2, U2.7 (VCC)
VUSB: F1.1
