spassigl/KicadLibs/Design Blocks/Power.kicad_blocks/AC Line to 5V via transformer.kicad_block/AC Line to 5V via transformer.kicad_sch

## KiCad design Design Blocks/Power.kicad_blocks/AC Line to 5V via transformer.kicad_block/AC Line to 5V via transformer.kicad_sch (2026-04-27)

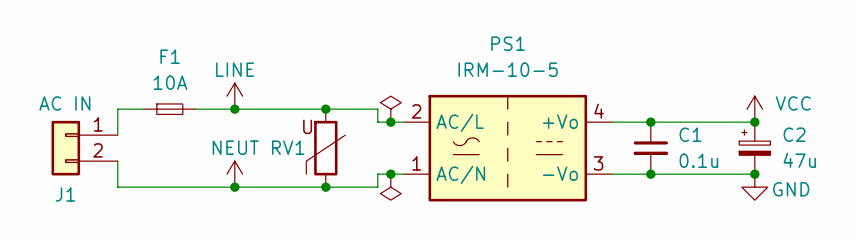
[picture p48: schematic AC Line to 5V via transformer.kicad_sch]

Parts:
C1: 0.1u; C_0603_1608Metric
C2: 47u; CP_Elec_6.3x5.7
F1: 10A; Schurter_0751.0110; JLCPCB Part # C3207451
J1: AC IN; WJ129V-7.62-02P; JLCPCB Part # C54802
PS1: IRM-10-5; MeanWell_IRM-10-xx_THT; JLCPCB Part # C2857903
RV1: Varistor; RV_Disc_D12mm_W3.9mm_P7.5mm; JLCPCB Part # C136817

Connections:
GND: C1.2, C2.2, PS1.3 (-Vo)
LINE: F1.2, PS1.2 (AC/L), RV1.2
NEUT: J1.2, PS1.1 (AC/N), RV1.1
unnamed: F1.1, J1.1
VCC: C1.1, C2.1, PS1.4 (+Vo)
