spassigl/KicadLibs/Design Blocks/Power.kicad_blocks/Power OR-ing.kicad_block/Power OR-ing.kicad_sch

## KiCad design Design Blocks/Power.kicad_blocks/Power OR-ing.kicad_block/Power OR-ing.kicad_sch (2026-04-27)

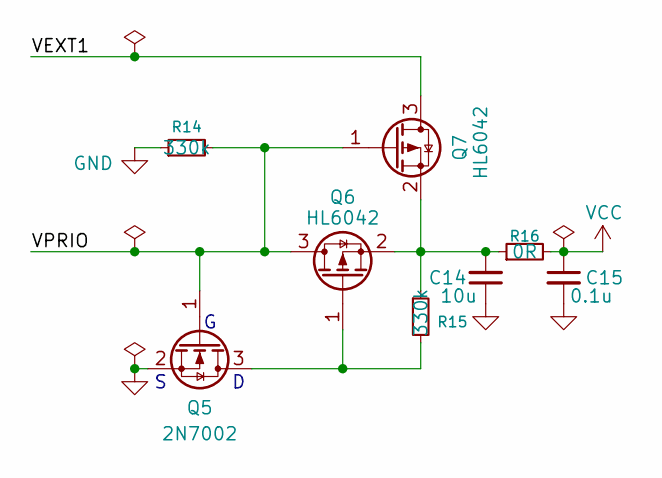
[picture p49: schematic Power OR-ing.kicad_sch]

Parts:
C14: 10u; C_0805_2012Metric; LCSC C15850
C15: 0.1u; C_0603_1608Metric; LCSC C14663
Q5: 2N7002; SOT-23; LCSC C8545
Q6, Q7: HL6042; SOT-23; Part HL6042; LCSC C28646264
R14, R15: 330k; R_0603_1608Metric; LCSC C23137
R16: 0R; R_0603_1608Metric; LCSC C21189

Connections:
GND: C14.1, C15.2, Q5.2 (S), R14.1
unnamed: C14.2, Q6.2 (S), Q7.2 (S), R15.1, R16.1
unnamed: Q5.3 (D), Q6.1 (G), R15.2
VCC: C15.1, R16.2
VEXT1: Q7.3 (D)
VPRIO: Q5.1 (G), Q6.3 (D), Q7.1 (G), R14.2
