spassigl/KicadLibs/Design Blocks/Standard analog.kicad_blocks/Speaker connection via NPN S8050.kicad_block/Speaker connection via NPN S8050.kicad_sch

## KiCad design Design Blocks/Standard analog.kicad_blocks/Speaker connection via NPN S8050.kicad_block/Speaker connection via NPN S8050.kicad_sch (2026-04-27)

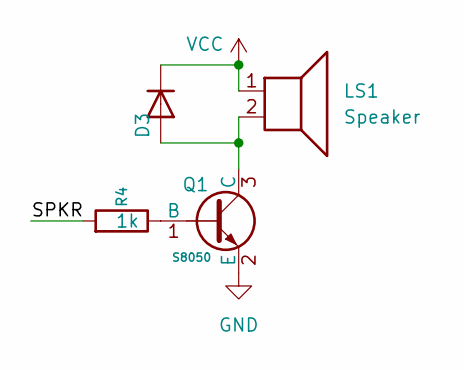
[picture p50: schematic Speaker connection via NPN S8050.kicad_sch]

Parts:
D3: 1N4148WS; D_SOD-123FL; Voltage - Forward(Vf@If) 1V@1.0A; Voltage - DC Reverse(Vr) 50V; Part 1N4001W; LCSC PN C2898400
LS1: Speaker; Buzzer_MLT-9650; LCSC PN C96127
Q1: S8050; Q_SOT-23; Part S8050; LCSC C364312
R4: 1k; R_0603; Overload Voltage (Max) 75V; Tolerance ±1%; Part 0603WAF1001T5E; LCSC C21190

Connections:
GND: Q1.2 (E)
unnamed: D3.2, LS1.2, Q1.3 (C)
unnamed: Q1.1 (B), R4.2
SPKR: R4.1
VCC: D3.1, LS1.1
