spassigl/KicadLibs/Design Blocks/atmelblocks.kicad_blocks/ATMega32A, 16 MHz clock.kicad_block/ATMega32A, 16 MHz clock.kicad_sch

## KiCad design Design Blocks/atmelblocks.kicad_blocks/ATMega32A, 16 MHz clock.kicad_block/ATMega32A, 16 MHz clock.kicad_sch (2026-04-27)

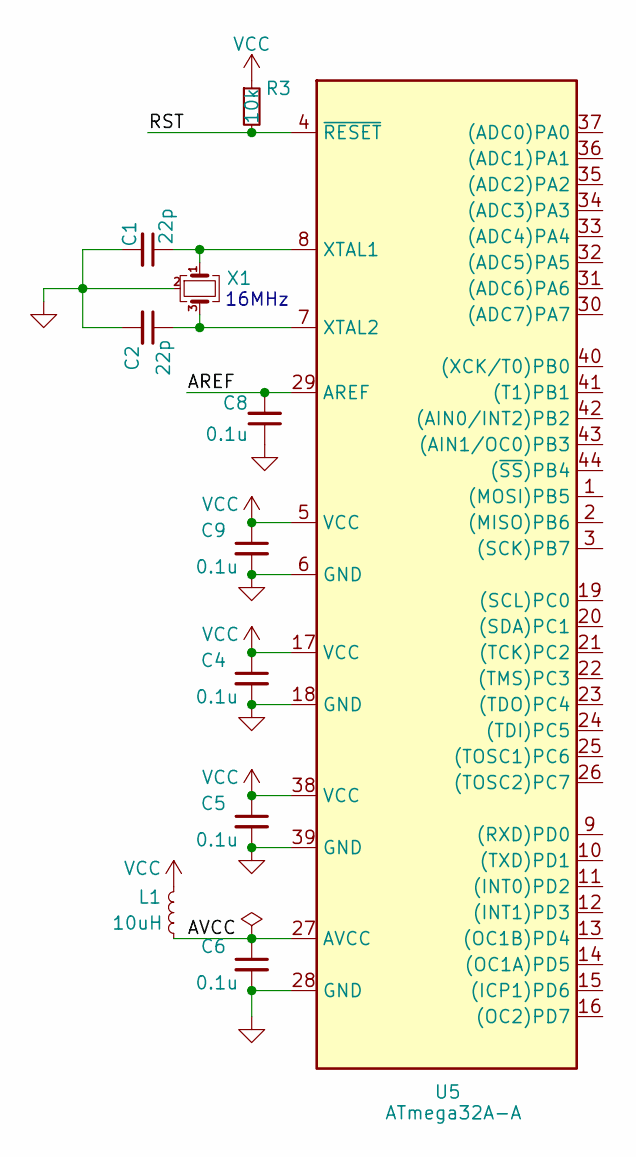
[picture p51: schematic ATMega32A, 16 MHz clock.kicad_sch]

Parts:
C1, C2: 22p; C_0603_1608Metric; LCSC C1653
C4, C5, C6, C8, C9: 0.1u; C_0603_1608Metric; LCSC C14663
L1: 10uH; L_0805_2012Metric; LCSC C2909263
R3: 10k; R_0603_1608Metric; LCSC C25804
U5: ATmega32A-A; TQFP-44_10x10mm_P0.8mm; LCSC C5659
X1: 16MHz; Crystal_SMD_3225-4Pin_3.2x2.5mm; LCSC C13738

Connections:
AREF: C8.2, U5.29 (AREF)
AVCC: C6.1, L1.2, U5.27 (AVCC)
GND: C1.2, C2.2, C4.2, C5.2, C6.2, C8.1, C9.2, U5.6 (GND), U5.18 (GND), U5.28 (GND), U5.39 (GND), X1.2 (G), X1.4 (G)
unnamed: C1.1, U5.8 (XTAL1), X1.1
unnamed: C2.1, U5.7 (XTAL2), X1.3
RST: R3.2, U5.4 (~RESET)
VCC: C4.1, C5.1, C9.1, L1.1, R3.1, U5.5 (VCC), U5.17 (VCC), U5.38 (VCC)

Notes on the sheet:
16MHz
