spassigl/KicadLibs/Design Blocks/atmelblocks.kicad_blocks/SPI header and SRV05 ESD protection.kicad_block/SPI header and SRV05 ESD protection.kicad_sch

## KiCad design Design Blocks/atmelblocks.kicad_blocks/SPI header and SRV05 ESD protection.kicad_block/SPI header and SRV05 ESD protection.kicad_sch (2026-04-27)

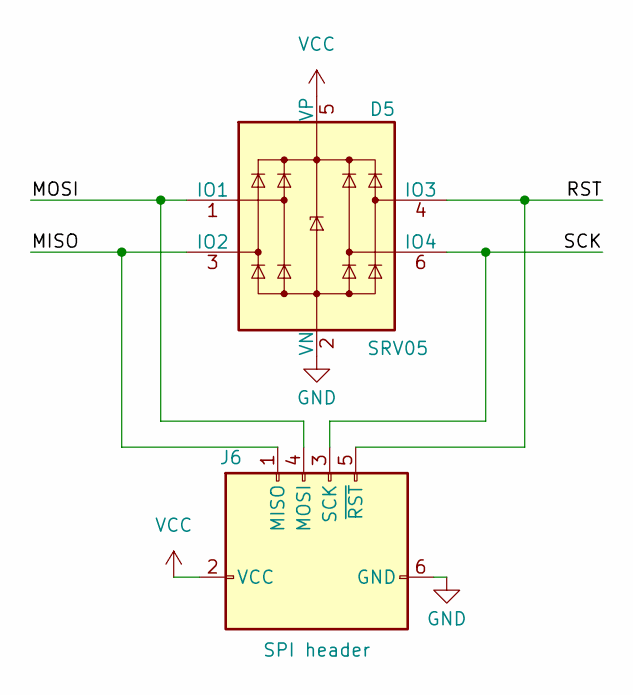
[picture p52: schematic SPI header and SRV05 ESD protection.kicad_sch]

Parts:
D5: SRV05; SOT-23-6; LCSC C85364
J6: SPI header; IDC-Header_2x03_P2.54mm_Vertical; LCSC C492441

Connections:
GND: D5.2 (VN), J6.6 (GND)
MISO: D5.3 (IO2), J6.1 (MISO)
MOSI: D5.1 (IO1), J6.4 (MOSI)
RST: D5.4 (IO3), J6.5 (~RST)
SCK: D5.6 (IO4), J6.3 (SCK)
VCC: D5.5 (VP), J6.2 (VCC)
