spassigl/KicadLibs/(commit log)

2026-02-15 Added 3d models
    [07D511.step, D6CXXF1LFS.step, ESD5B5.step, FJ81XXXH.step, FJ8301BH.step, G5CA-1A4.step, IRM-10-5.step, KW1-802.step]
2026-02-20 Reviewed some footprints and added new
    [0530470210.stp, 0530470410.stp, HF32FA[1].stp, WJ128V-5.0-02P-14-00A.step, WJ129V-7.62-02P.step]
2026-04-27 new models
    [320.02E11xxx + 320.094.step, 320.02E11xxx.stp, 320.094xxx.stp, 6Jxxx.stp, B3F-105x.step, Cap.step, ConnFly_DS1128_NoLED.step, D6R90F1LFS.stp]
2026-04-27 new blocks
    [AC Line to 5V via transformer.kicad_sch, ATMega32A, 16 MHz clock.kicad_sch, I2C extender + RJ45 + ESD protection .kicad_sch, Power OR-ing.kicad_sch, SPI header and SRV05 ESD protection.kicad_sch, Speaker connection via NPN S8050.kicad_sch, USBC + CH340X + ESD protection.kicad_sch]
2026-04-29 new footprints
