spassigl/KicadLibs/(notices)

Notices in the files:
3D Models/D6R90F1LFS.stp:
author */ ('License CC BY-ND 4.0'),
